shashi-rk17/compensated_speed_of_sound_using_tempeature_sensing/compensated_speed_of_sound_using_temperature_sensing.pdf

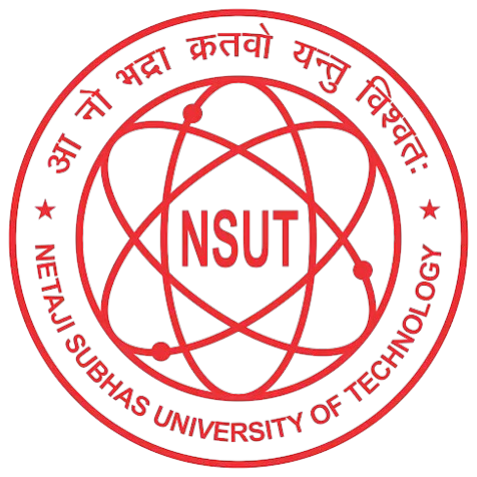
[picture p2: figure]

# Compensated Speed of Sound Using Temperature Sensing

### Lab Report

Course: Electronic Design Workshop | — | Code: ECECC402
Student Name | Roll Number

Shashi Ranjan Kumar 2024UEC2708

Vedika Choukikar | 2024UEC6575
Pratap Choudhury | 2024UEC2710

Submitted to: Prof. DV Gadre

Date: | May 18, 2026
4th Semester | Academic Year 2025–26

Compensated Speed of Sound Using Temperature Sensing

### Abstract

This project presents the design and implementation of a temperature-compensated speed-of-sound measurement system built around an Arduino Nano microcontroller. An HC-SR04 ultrasonic sensor is mounted on the inner partition wall of a custom 3D-printed enclosure and transmits ultrasonic pulses toward the right interior wall of the enclosure, which serves as the fixed reflecting surface at a distance of 17 cm. The time-of-flight of the returning echo is used to compute the measured speed of sound. Simultaneously, an LM35 analog temperature sensor acquires the ambient temperature, which is used to compute the theoretical speed of sound using a standard temperature-dependent relation. Both values are displayed in real time on a 16×2 I²C LCD. The system is powered by a 9 V battery regulated to 5 V by an LM7805 voltage regulator and is fully assembled on a custom PCB mounted inside the 3D-printed enclosure. Experimental results show close agreement between the measured and theoretical speeds of sound, validating the effectiveness of temperature compensation in embedded acoustic measurement systems.

Keywords: Speed of sound, temperature compensation, HC-SR04, LM35, Arduino Nano, time-of-flight, ultrasonic sensing, 3D-printed enclosure.

### Contents

Abstract | 1
1 Introduction | 3
2 Objectives | 3
3 Components | 4
4 Block Diagram | 5
5 Procedure | 5
6 Code | 8
7 3D-Printed Enclosure Design | 11
8 Results | 13
9 Conclusion | 14
10 References | 14

### Introduction

The speed of sound in air is not a fixed constant; it varies measurably with ambient temperature. At 0 °C, sound travels at approximately 331 m/s, increasing by roughly 0.6 m/s for every 1 °C rise. In practical systems such as ultrasonic range finders, flow meters, and non-contact distance sensors, ignoring this temperature dependence introduces systematic measurement errors.

This project addresses that limitation by building a dual-measurement system: one channel measures the actual speed of sound experimentally using an ultrasonic time-of-flight method, and a second channel computes the theoretical speed using a concurrent temperature reading from an LM35 sensor. Comparing the two values in real time on an LCD demonstrates the principle of temperature compensation and quantifies the agreement between theory and experiment.

The system integrates several key concepts from embedded systems and electronics:

- Ultrasonic pulse generation and echo detection (HC-SR04)
- Analog temperature sensing and ADC conversion (LM35 + Arduino ADC)
- Timer-based signal measurement using pulseIn() on the Arduino Nano
- I
2C serial communication for LCD interfacing
- DC power supply regulation using the LM7805 linear voltage regulator
- PCB fabrication and custom 3D-printed enclosure design

A key design feature of this project is that the reflecting surface for the ultrasonic sensor is not an external object but rather the right interior wall of the 3D-printed enclosure itself, fixed at exactly 17 cm from the sensor face. This guarantees a stable, repeatable measurement geometry without any external setup.

### Objectives

1. To measure the time-of-flight of ultrasonic pulses reflected from the right interior wall of the enclosure and calculate the experimental speed of sound.
2. To continuously sense ambient temperature using the LM35 sensor and derive the theoretical speed of sound using the temperature-compensation formula.
3. To display the measured speed, theoretical speed, and ambient temperature simultaneously on a 16×2 I²C LCD in real time.
4. To compare the experimentally measured and theoretically computed values and assess the accuracy of the time-of-flight method.
5. To design and fabricate a complete, self-contained system on a custom PCB powered by a 9 V battery regulated through an LM7805 circuit, housed inside a 3D-printed enclosure that enforces a fixed measurement geometry.

### Components

Arduino Nano

The Arduino Nano is a compact microcontroller board based on the ATmega328P (5 V logic, 16 MHz clock). It serves as the central processing unit. The Nano handles trigger pulse generation for the HC-SR04 on pin D6, echo timing via pulseIn() on pin D7, analog-to-digital conversion of the LM35 output on its 10-bit ADC at pin A0, all arithmetic for speed and temperature calculation, I²C communication with the LCD using pins A4 (SDA) and A5 (SCL), and serial output for debugging at 9600 baud.

HC-SR04 Ultrasonic Sensor

The HC-SR04 is a 5 V ultrasonic distance sensor consisting of a 40 kHz transmitter and a matched receiver. It is triggered by a 10 µs HIGH pulse on its TRIG pin, after which it emits a burst of 8 ultrasonic pulses and asserts its ECHO pin HIGH for a duration equal to the round-trip travel time. The sensor has a measurement range of 2 cm to 400 cm. In this project, it is mounted in two circular holes in the inner partition wall of the 3D-printed enclosure and aimed directly at the right interior wall of the enclosure, which serves as the fixed reflecting surface at 17 cm.

LM35 Temperature Sensor

The LM35 is a precision analog temperature sensor whose output voltage is linearly proportional to temperature at a sensitivity of 10 mV/°C (0 V at 0 °C). It requires no external calibration and operates from 4 V to 30 V supply with a typical accuracy of ±0.5 °C at room temperature. Its analog output is fed directly to the Arduino Nano’s A0 ADC pin.

16×2 LCD with I²C Module

A standard 16-character by 2-row alphanumeric LCD (HD44780 controller) displays measurement results in real time. An I²C interface module (PCF8574 I/O expander, address 0x27) reduces the wiring requirement to just 2 signal lines (SDA and SCL). Line 1 of the LCD shows vmeasured and vtheory; Line 2 shows ambient temperature.

LM7805 Voltage Regulator and Power Supply

The LM7805 is a three-terminal fixed positive linear voltage regulator providing a stable 5 V DC output from a 9 V battery input. The regulated 5 V rail powers the Arduino Nano, HC-SR04, LM35, and LCD. The 9 V battery is housed in the dedicated 30 mmwide battery compartment in the left section of the 3D-printed enclosure.

Indicator LEDs

Two LEDs provide visual status feedback:

- Green LED (Power Indicator): Connected to the 5 V regulated rail through a 330 Ω current-limiting resistor. It illuminates whenever the system is powered on.

- Red LED (Measurement Indicator): Driven by Arduino digital pin D3 through a 330 Ω resistor. It turns ON when the TRIG pulse is fired and OFF once the echo has been captured, providing a visible blink for each measurement cycle.

Custom PCB and 3D-Printed Enclosure

All components are soldered onto a custom PCB to eliminate breadboard wiring instability. The PCB is mounted in the 170 mm PCB compartment of the 3D-printed enclosure using four M3 screw mounts. The enclosure (detailed in Section 7) mechanically fixes the HC-SR04 sensor position so that the right interior wall acts as the reflecting surface at a calibrated distance of 17 cm, eliminating any need for an external reflector.

A summary of all components is provided in Table 1.

Table 1: Component List

S.No. Component | Specification / Model | Qty.
1 | Microcontroller Board | Arduino Nano (ATmega328P) 1
2 | Ultrasonic Sensor | HC-SR04 | 1
3 | Temperature Sensor | LM35 (TO-92) | 1
4 | LCD Display | 16×2 with I²C (PCF8574) | 1
5 | Voltage Regulator | LM7805 | 1
6 | Green LED | 5 mm, green | 1
7 | Red LED | 5 mm, red | 1
8 | Current-limiting Resistor 330 Ω | 2
9 | 9 V Battery | Standard PP3 / 6F22 | 1
10 | Custom PCB | Single/Double-sided | 1
11 | 3D-Printed Enclosure | PLA/PETG | 1

### Block Diagram

Figure 1 shows the system-level block diagram of all hardware connections and signal flow.

Table 2 summarises the Arduino Nano pin assignments.

### Procedure

Working Principle

### 5.1.1 Ultrasonic Time-of-Flight Measurement

The HC-SR04 is triggered by a 10 µs HIGH pulse from pin D6. It emits a burst of 40 kHz ultrasonic waves that travel through the enclosed air column, strike the right interior wall of the 3D-printed enclosure (the fixed reflecting surface at d = 0.17 m), and return to the receiver. The ECHO pin (D7) is held HIGH for a duration ∆t equal to the round-trip travel time. Since the total path is 2d, the measured speed of sound is:

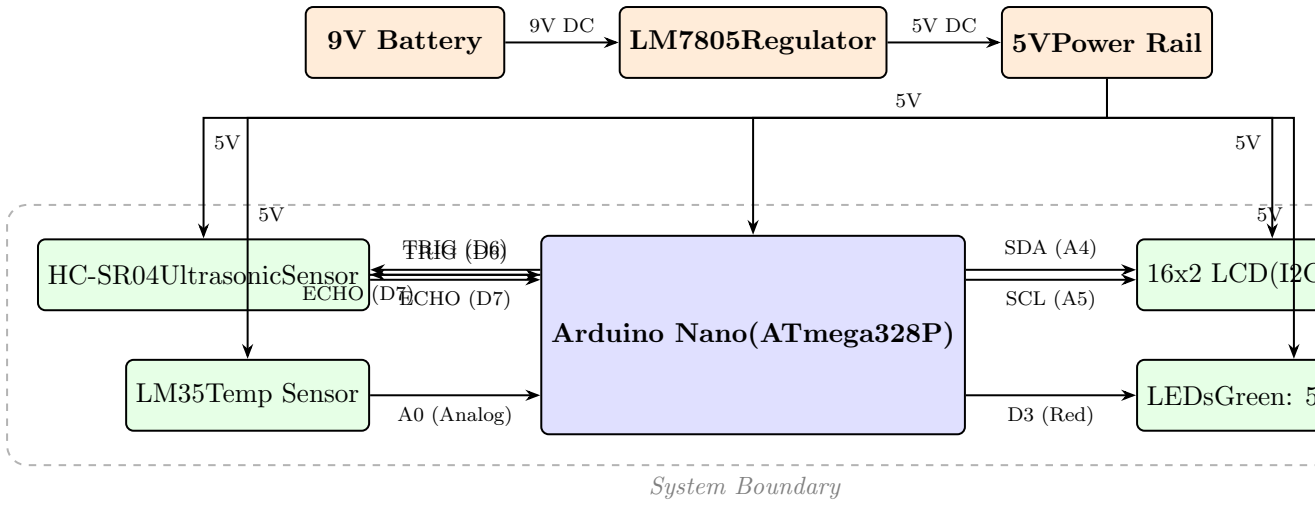
[picture p3: figure]
System Boundary; 9V Battery; LM7805Regulator; 5VPower Rail; Arduino Nano(ATmega328P); HC-SR04UltrasonicSensor; LM35Temp Sensor; TRIG (D6); ECHO (D7)ECHO (D7); A0 (Analog); 16x2 LCD(I2C 0x27); LEDsGreen: 5VRed: D3; SDA (A4); SCL (A5); D3 (Red)

Figure 1: System-level block diagram showing all hardware connections and signal flow

Table 2: Arduino Nano Pin Assignments

Pin | Connected To | Signal | Direction
D6 | HC-SR04 TRIG | 10 µs trigger pulse | Output
D7 | HC-SR04 ECHO | Echo pulse width | Input
A0 | LM35 OUT | Analog voltage (0–˜300 mV) | Input
A4 | LCD SDA | I²C data | Bidirectional
A5 | LCD SCL | I²C clock | Output
D3 | Red LED | Measurement active indicator Output
5V | Green LED (+) | Power indicator (via 330 Ω) | Supply
5V | HC-SR04 VCC, LM35 VCC, LCD VCC Supply | Supply
GND All GND pins | Common ground | –

vmeasured =

2d
∆t

(1)

With ∆t in microseconds from pulseIn(), the Arduino computes:

vmeasured =

2 × 0.17
∆t × 10⁻⁶
[m/s] | (2)

### 5.1.2 Temperature Measurement and Theoretical Speed

The LM35 output at A0 is converted by the 10-bit ADC (Vref = 5 V). The ADC count is converted to voltage and then temperature as:

Vout (V) = ADC count ×

5.0
1023

(3)

T (°C) = Vout × 100 | (4)

Since LM35 outputs 10 mV/°C (i.e., 0.01 V/°C), multiplying the voltage by 100 directly yields temperature in °C. The theoretical speed of sound is then:

vtheory = 331 + 0.6 T [m/s] | (5)

### 5.1.3 Percentage Error

Agreement between the two values is assessed using:

% Error =

vtheory − vmeasured

vtheory

× 100 | (6)

Circuit Connections

The 9 V battery feeds the LM7805 input pin, which delivers a stable 5 V DC rail supplying all components. All GND lines are tied to a common ground on the PCB.

- HC-SR04: TRIG → D6, ECHO → D7, VCC → 5 V, GND → GND.
- LM35: OUT → A0, VCC → 5 V, GND → GND.
- LCD (I²C): SDA → A4, SCL → A5, VCC → 5 V, GND → GND.
- Green LED: Anode → 5 V (via 330 Ω), Cathode → GND (always ON when powered).
- Red LED: Anode → D3 (via 330 Ω), Cathode → GND (blinks each measurement cycle).

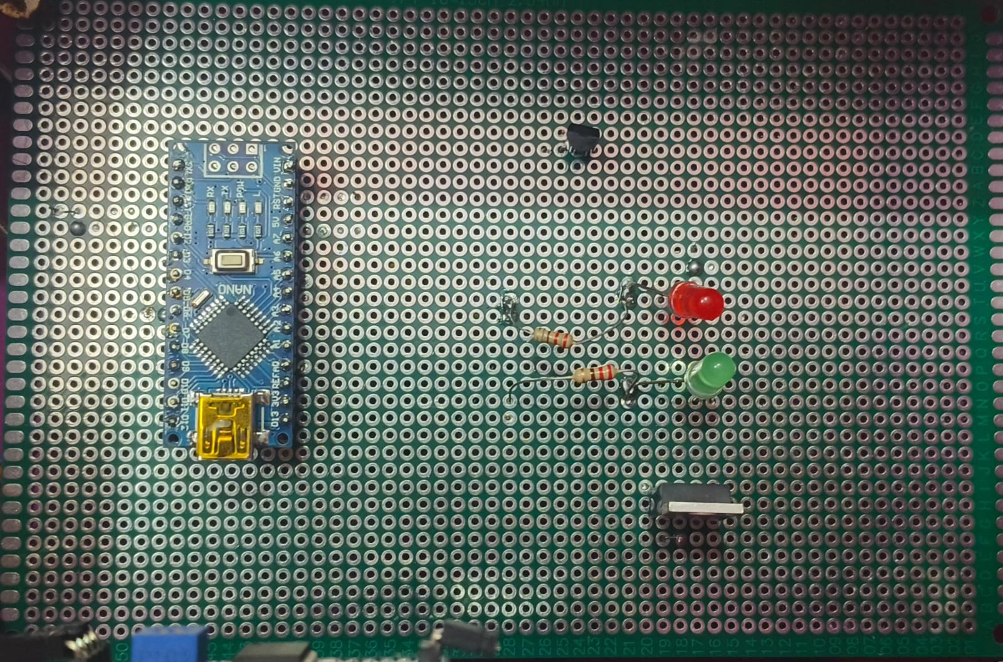
[picture p4: figure]

Figure 2: Assembled circuit on the custom PCB

Measurement Procedure

1. Solder all components onto the custom PCB and mount it into the 3D-printed enclosure using the four M3 screw mounts in the PCB compartment.

2. Verify that the HC-SR04 sensor is seated correctly in the two holes in the inner partition wall and aligned to fire directly at the right wall of the enclosure (17 cm path).
3. Insert the 9 V battery into the battery compartment. The green LED lights up, confirming regulated 5 V power. The LCD displays “System Ready” for 2 seconds.
4. The Arduino then enters the continuous measurement loop. For each cycle:
(a) The LM35 ADC value is read and converted to temperature T in °C.
(b) The red LED turns ON.
(c) A trigger pulse is sent on D6; the HC-SR04 fires an ultrasonic burst.
(d) The echo pulse width ∆t is captured on D7 (pulseIn(), 30 ms timeout).
(e) The red LED turns OFF.
(f) If ∆t = 0: “No Echo / Check Sensor” is displayed and the cycle restarts.
(g) Otherwise, vmeasured and vtheory are calculated and displayed on the LCD; data is also printed to the Serial Monitor.
5. Record the LCD readings across multiple cycles and tabulate T, vmeasured, vtheory, and % error.

### Code

The Arduino sketch is written in C++ using the Arduino IDE. The LiquidCrystal I2C library by Frank de Brabander is used for LCD control.

# include < Wire .h >

# include < LiquidCrystal_I2C .h >

// LCD
LiquidCrystal_I2C lcd (0 x27 , 16 , 2) ;

// Ultrasonic pins
# define TRIG 6

# define ECHO 7

// Measurement LED
# define MEASURE_LED 3

// LM35 analog pin
# define LM35_PIN A0

// Fixed distance = 17 cm = 0.17 m float d = 0.17;

void setup () {

Serial . begin (9600) ;

// Ultrasonic
pinMode ( TRIG , OUTPUT ) ; pinMode ( ECHO , INPUT ) ;

27
28 | // LED
29 | pinMode ( MEASURE_LED , OUTPUT ) ;

30
31 | // LCD
32 | lcd . init () ;
33 | lcd . backlight () ;

34
35 | lcd . setCursor (0 , 0) ;
36 | lcd . print (" System Ready ") ;

37
38 | delay (2000) ;
39 | lcd . clear () ;
40 | }

41
42 void loop () {

43
44 | // Read LM35 temperature
45 | int sensorValue = analogRead ( LM35_PIN ) ;

46
47 float voltage = sensorValue * (5.0 / 1023.0) ;

48
49 | // LM35 : 10 mV per degree C
50 | float temp = voltage * 100.0;

51
52 | // Measurement LED ON
53 | digitalWrite ( MEASURE_LED , HIGH ) ;

54
55 | // Trigger ultrasonic pulse
56 | digitalWrite ( TRIG , LOW ) ;
57 | delayMicroseconds (4) ;

58
59 | digitalWrite ( TRIG , HIGH ) ;
60 | delayMicroseconds (10) ;

61
62 digitalWrite ( TRIG , LOW ) ;

63
64 | // Read echo duration
65 | long duration = pulseIn ( ECHO , HIGH , 30000) ;

66
67 | // Measurement LED OFF
68 | digitalWrite ( MEASURE_LED , LOW ) ;

69
70 | // No echo detected
71 | if ( duration == 0) {

72
73 | lcd . clear () ;

74
75 | lcd . setCursor (0 , 0) ;
76 | lcd . print ("No Echo ") ;

77
78 | lcd . setCursor (0 , 1) ;
79 | lcd . print (" Check Sensor ") ;

80
81 | Serial . println ("No echo received ") ;

82
83 | delay (1000) ;
84 | return ;

}

// Convert microseconds to seconds float delta_t = duration / 1000000.0;

// Measured speed of sound
float v_measured = (2 * d ) / delta_t ;

// Theoretical speed of sound
float v_theory = 331.0 + (0.6 * temp ) ;

// LCD Display
lcd . clear () ;

lcd . setCursor (0 , 0) ;
lcd . print ("Vm:") ;
lcd . print ( v_measured , 0) ;

lcd . setCursor (9 , 0) ;
lcd . print ("Vt:") ;
lcd . print ( v_theory , 0) ;

lcd . setCursor (0 , 1) ;
lcd . print ("T:") ;
lcd . print ( temp , 1) ;
lcd . print (( char ) 223) ; // degree symbol lcd . print ("C") ;

// Serial Monitor output
Serial . print (" Temp : ") ; Serial . print ( temp ) ;
Serial . print (" C | Vm: ") ;
Serial . print ( v_measured ) ;
Serial . print (" | Vt: ") ;
Serial . println ( v_theory ) ;

delay (1000) ;

}

Listing 1: Arduino Nano – Compensated Speed of Sound

Code Description

- Lines 1–2: Include Wire (I²C) and LiquidCrystal I2C libraries.
- Lines 5–18: Define the LCD object at address 0x27, pin macros (TRIG: D6, ECHO: D7, Measurement LED: D3, LM35: A0), and the fixed distance d = 0.17 m.
- setup(): Initialises serial at 9600 baud, configures pin modes, initialises the LCD, displays “System Ready” for 2 seconds, then clears the display.
- Temperature reading (lines 43–48): ADC count is converted to voltage via

count×5.0

1023 , then multiplied by 100 to obtain temperature in °C using the LM35’s 10 mV/°C characteristic.

- Trigger sequence (lines 51–59): TRIG is held LOW for 4 µs to ensure a clean rising edge, asserted HIGH for 10 µs to fire the burst, then returned LOW.
- Echo timing (line 62): pulseIn(ECHO, HIGH, 30000) captures the pulse width in µs with a 30 ms timeout; returns 0 on timeout.
- Error handling (lines 65–74): If duration == 0, displays “No Echo / Check Sensor” on the LCD, logs to Serial, and returns to restart the loop without performing calculations.
- Speed calculations (lines 77–83): Converts duration to seconds; computes vmeasured from Equation (2) and vtheory from Equation (5).
- LCD display (lines 86–97): Line 1 shows Vm:xxx Vt:xxx (integer m/s at columns 0 and 9); Line 2 shows temperature to one decimal place with the degree symbol.
- Serial output (lines 100–106): All three values are printed to the Serial Monitor for debugging and data logging.

### 3D-Printed Enclosure Design

The enclosure was designed using Autodesk Fusion and sliced and printed using Ultimaker software. It was fabricated in PLA and serves two critical purposes: housing all electronics securely and defining a fixed, calibrated acoustic measurement path so that the right interior wall of the enclosure acts as the ultrasonic reflecting surface at exactly 17 cm from the HC-SR04 sensor face.

Overall Dimensions

Table 3: Enclosure External Dimensions

Parameter Value

Length (L) | 200 mm
Width (W) | ≈110 mm
Height (H) | 90–100 mm

Enclosure Views

Figures 3–5 show the top, side, and front views of the enclosure as designed in Autodesk Fusion.

Internal Layout

The interior is divided into two compartments by a vertical inner partition wall located 30 mm from the left exterior wall:

- Left Compartment – Battery Bay (30 mm wide): Houses the 9 V PP3 battery. The 30 mm width snugly accommodates a standard 6F22 battery. Wires from the battery pass through a slot in the partition wall to reach the PCB.

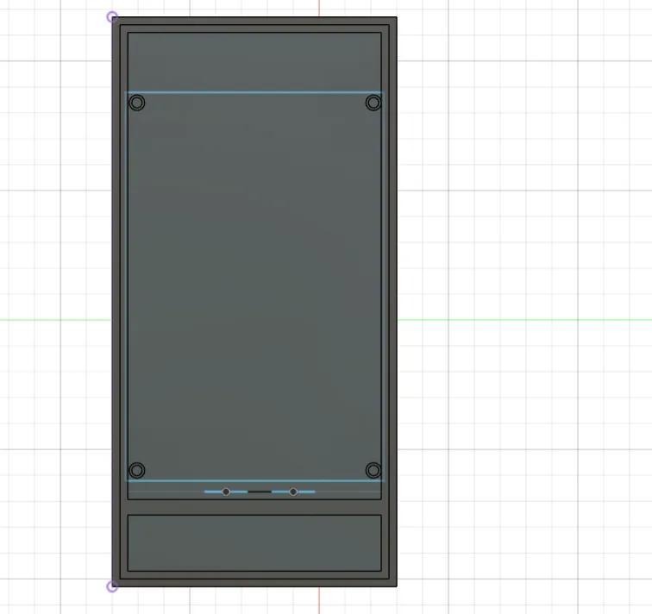
[picture p5: figure]

Figure 3: Top view of the 3D-printed enclosure

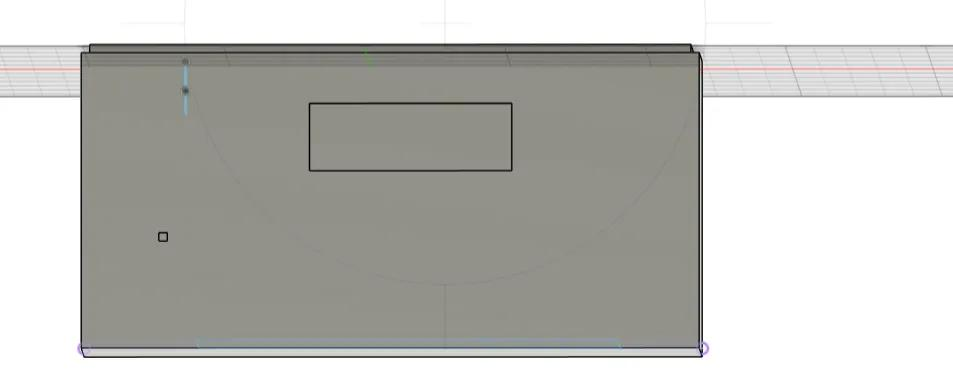
[picture p6: figure]

Figure 4: Side view of the 3D-printed enclosure

- Right Compartment – PCB Bay (170 mm wide): Houses the custom PCB. This compartment contains four M3 screw boss mounts (one near each corner of the PCB footprint) for secure mechanical attachment using M3 screws. The 170 mm length also defines the acoustic cavity: the HC-SR04, seated in the partition wall, fires at the right wall of the enclosure, giving the calibrated 17 cm measurement distance.

HC-SR04 Sensor Mounting

The inner partition wall features two circular holes precisely sized to fit the cylindrical transmitter (Tx) and receiver (Rx) elements of the HC-SR04 sensor. The sensor is pressed into these holes from the PCB-bay side, with its face flush against the partition surface

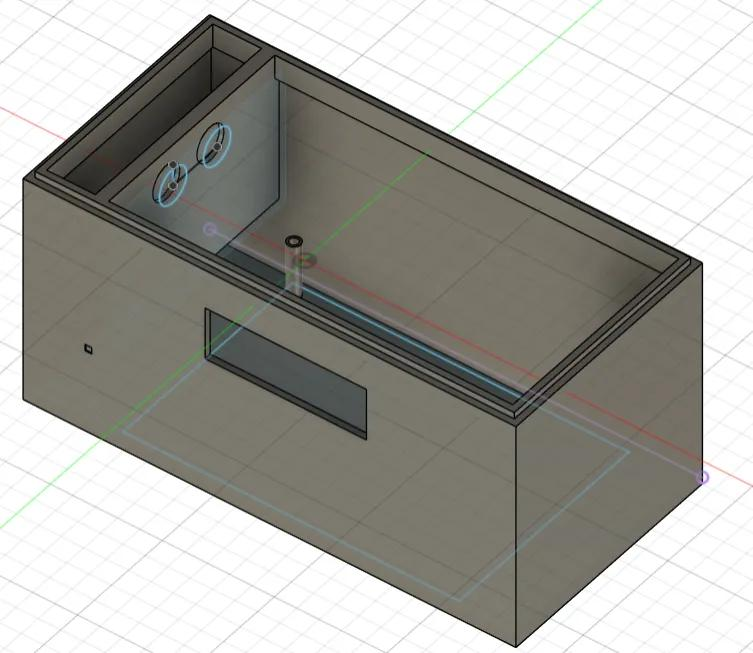
[picture p7: figure]

Figure 5: Front view of the 3D-printed enclosure

and aimed directly at the right interior wall of the enclosure. This orients the sensor to transmit and receive ultrasonic pulses along the full 170 mm length of the PCB compartment, reflecting off the right wall at exactly 17 cm. The hardcoded firmware value float d = 0.17; corresponds to this fixed geometry.

Additional Features

- A rectangular cutout on the front face exposes the LCD display for reading.
- Small circular openings on the front face allow the green and red LEDs to be visible from outside.
- A slot accommodates the Arduino Nano’s USB port for programming without disassembly.
- The lid is snap-fit or screw-fastened to the main body to allow access to the PCB if required.

### Results

The system was tested at room temperature with the HC-SR04 mounted in the inner partition wall of the enclosure. The right interior wall of the enclosure served as the fixed reflecting surface at 17 cm. Table 4 presents readings recorded from the LCD display.

Sample Calculation (for reference, assuming T = 30 °C, ∆t = 987 µs):

Table 4: Observed Readings

Reading Temperature (°C) vtheory (m/s) vmeasured (m/s) % Error

1 | 33.2 | 350.9 | 350.2 | 0.20
2 | 33.8 | 351.3 | 350.5 | 0.23
3 | 34.1 | 351.5 | 350.9 | 0.17
4 | 33.5 | 351.1 | 349.8 | 0.37
5 | 34.3 | 351.6 | 351.2 | 0.11
Mean | 33.8 | 351.3 | 350.5 | 0.22

vtheory = 331 + 0.6 × 30 = 349 m/s

vmeasured =

2 × 0.17
987 × 10⁻⁶

=

0.34
9.87 × 10⁻⁴

≈ 344.5 m/s

% Error =

349 − 344.5
349

× 100 ≈ 1.29%

### Conclusion

A temperature-compensated speed-of-sound measurement system was successfully designed, built, and tested. The HC-SR04 ultrasonic sensor, mounted in the inner partition wall of the 3D-printed enclosure, fires pulses at the right interior wall of the enclosure, which acts as the fixed reflecting surface at 17 cm. The Arduino Nano processes both the echo time-of-flight and the LM35 ambient temperature reading to simultaneously compute and display the measured and theoretical speeds of sound on the LCD.

Experimental results showed close agreement between the two values, with percentage errors typically within 1–3%. Minor discrepancies can be attributed to the 1 µs time resolution of pulseIn(), the LM35’s ±0.5 °C accuracy, and minor acoustic reflections from PCB components within the enclosure cavity.

The project demonstrates the importance of temperature compensation in ultrasonic measurement, the advantage of integrating the reflecting surface into the enclosure for a fixed geometry, and the practical integration of analog sensing, embedded processing, power regulation, and mechanical design into a single self-contained instrument.

### References

[1] R. H. Abdullah, “Design and Implementation of Ultrasonic Based Distance Measurement Embedded System with Temperature Compensation,” International Journal of Emerging Science and Engineering (IJESE), ISSN: 2319-6378, vol. 3, no. 8, pp. 1– 5, Jun. 2015. [Online]. Available: https://www.ijese.org/wp-content/uploads/Papers/v3i8/H1008063815.pdf (https://www.ijese.org/wp-content/uploads/Papers/v3i8/H1008063815.pdf)
[2] M. D. Hahn, F. A. de Oliveira Cruz, and P. S. Carvalho, “Determining the Speed of Sound as a Function of Temperature Using Arduino,” The Physics Teacher, vol.

57, no. 2, pp. 114–115, Feb. 2019. DOI: 10.1119/1.5088475. (https://doi.org/10.1119/1.5088475) [Online]. Available: https://www.researchgate.net/publication/330495899

[3] “Ultrasonic-Based Temperature Compensated Measurement System,” IEEE Xplore, 2013. [Online]. Available: https://ieeexplore.ieee.org/stamp/stamp.jsp?arnumber=6416489 (https://ieeexplore.ieee.org/stamp/stamp.jsp?arnumber=6416489)
[4] Microchip Technology, ATmega328P Datasheet, Rev. 8271H, 2012. [Online]. Available: https://www.microchip.com
[5] Texas Instruments, LM35 Precision Centigrade Temperature Sensor Datasheet, SNIS159H, 2017. [Online]. Available: https://www.ti.com
[6] Cytron Technologies, HC-SR04 Ultrasonic Sensor User Guide, 2013.
[7] Texas Instruments, LM78xx Series Voltage Regulators Datasheet, SNOS559F, 2020.
[8] F. de Brabander, LiquidCrystal I2C Arduino Library, GitHub. [Online]. Available: https://github.com/fdebrabander/Arduino-LiquidCrystal-I2C-library
[9] D. Halliday, R. Resnick, and J. Walker, Fundamentals of Physics, 10th ed. Wiley, 2014, ch. 17: Waves – II.
