shashi-rk17/compensated_speed_of_sound_using_tempeature_sensing/Screenshot 2026-06-25 201108.png

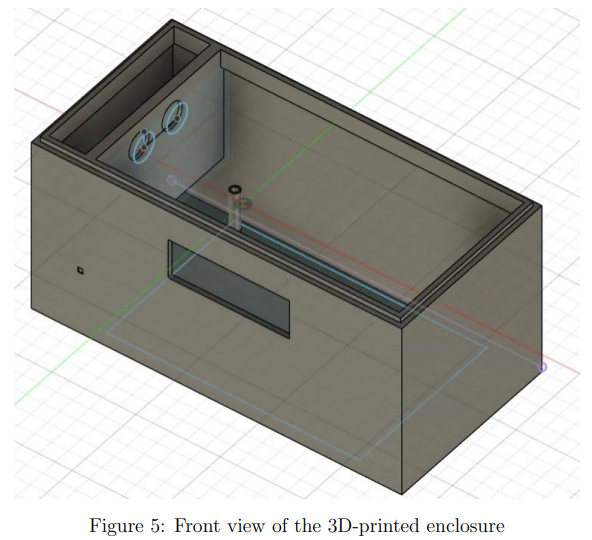
Screenshot 2026-06-25 201108.png
